akostelanska/NDE-Group-project/README.md

# NDE-Group-project
Repository for MPA-NDE Group Project
