akostelanska/NDE-Group-project/blok_schema.pdf

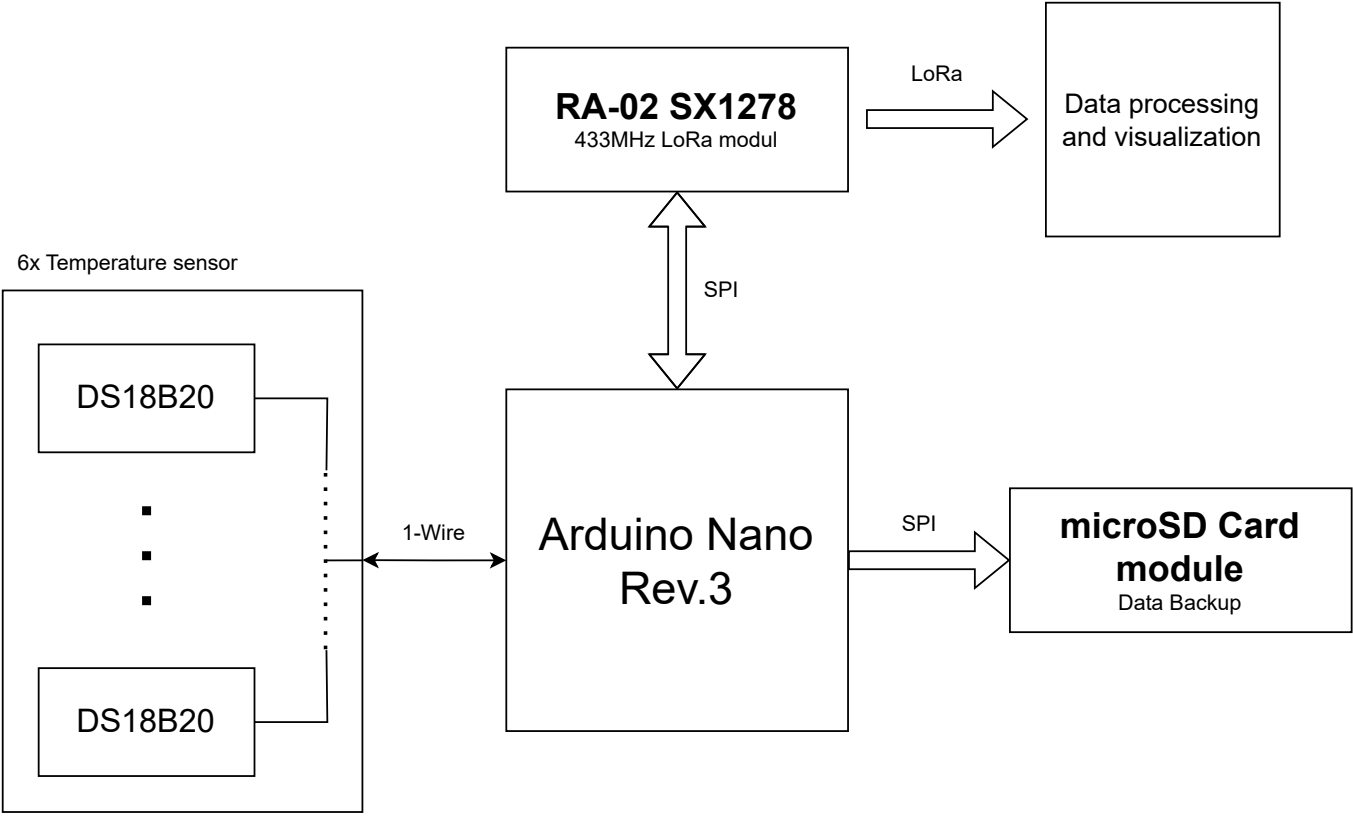
[picture p2: figure]
Arduino Nano Rev.3; 433MHz LoRa modul; Data processing and visualization; LoRa; SPI; 6x Temperature sensor; 1-Wire; microSD Card; module; Data Backup

## Power Supply Battery
