akostelanska/NDE-Group-project/HW/_lib/Ra-02 LoRa--3DModel-STEP-1.STEP

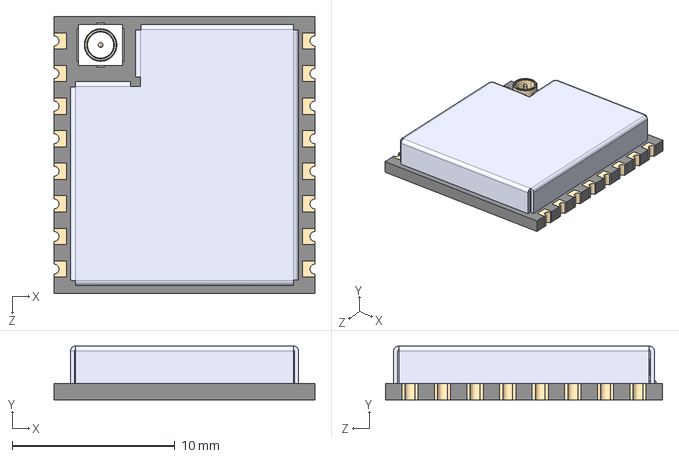
[picture p3: CAD file, 2024-03-19]
HW/_lib/Ra-02 LoRa--3DModel-STEP-1.STEP
16.0 x 3.30 x 17.0 mm
