akostelanska/NDE-Group-project/HW/_lib/LIB_MAX77827CEFD+T/MAX77827CEFD+T.stp

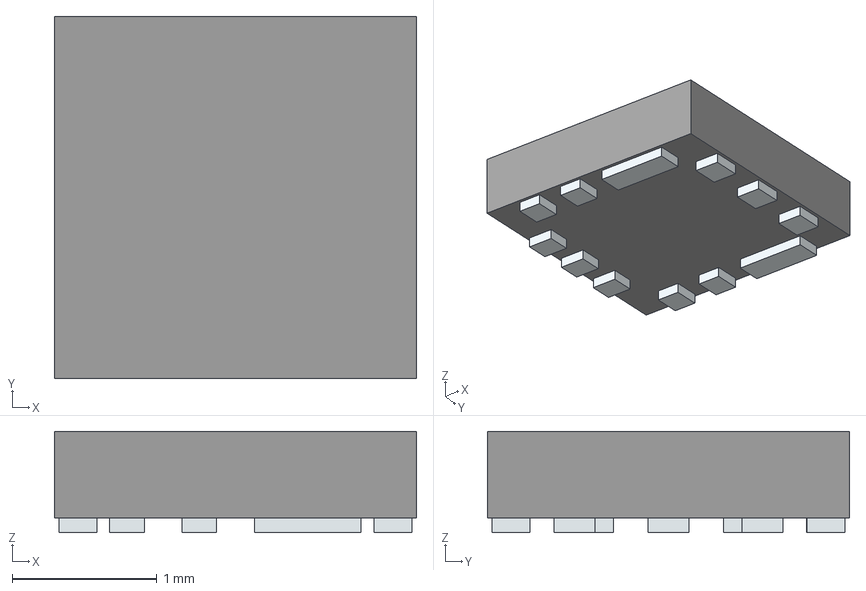
[picture p4: CAD file, 2024-02-26]
HW/_lib/LIB_MAX77827CEFD+T/MAX77827CEFD+T.stp
2.50 x 2.50 x 0.7 mm
Pins
