akostelanska/NDE-Group-project/HW/meracia_jednotka_v1.kicad_pcb

## KiCad design HW/meracia_jednotka_v1.kicad_pcb (2024-03-19)

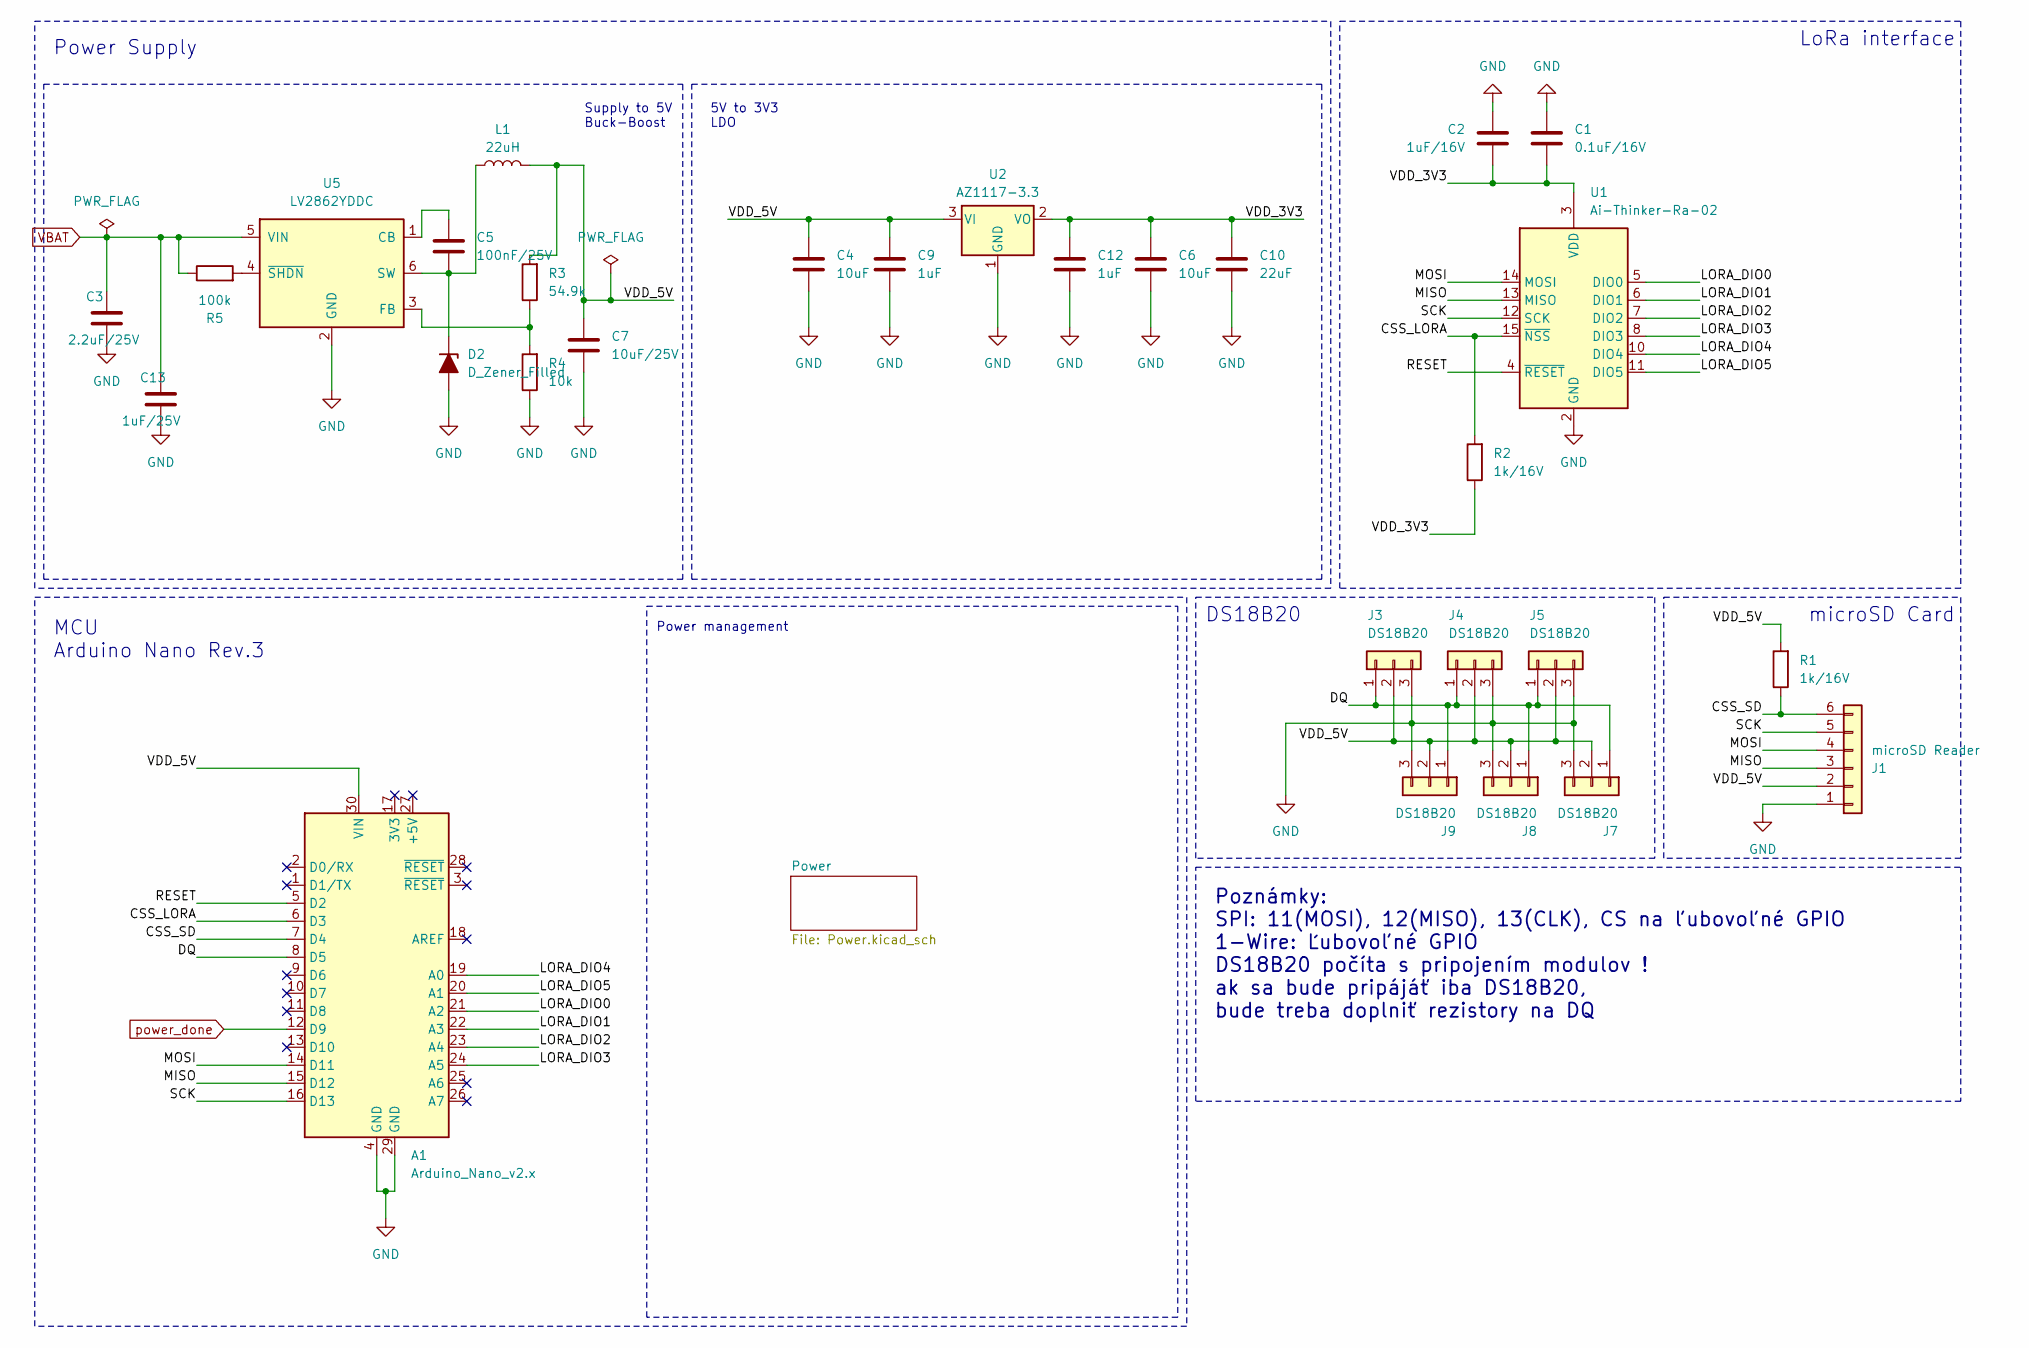
[picture p5: schematic meracia_jednotka_v1.kicad_sch]

Parts:
A1: Arduino_Nano_v2.x; Arduino_Nano
C1: 0.1uF/16V; C_1206_3216Metric_Pad1.33x1.80mm_HandSolder
C2: 1uF/16V; C_1206_3216Metric_Pad1.33x1.80mm_HandSolder
C3: 2.2uF/25V; C_1206_3216Metric_Pad1.33x1.80mm_HandSolder
C4, C6: 10uF; C_1206_3216Metric_Pad1.33x1.80mm_HandSolder
C5: 100nF/25V; C_1206_3216Metric_Pad1.33x1.80mm_HandSolder
C7: 10uF/25V; C_1206_3216Metric_Pad1.33x1.80mm_HandSolder
C9, C12: 1uF; C_0805_2012Metric_Pad1.18x1.45mm_HandSolder
C10: 22uF; C_1206_3216Metric_Pad1.33x1.80mm_HandSolder
C13: 1uF/25V; C_0805_2012Metric_Pad1.18x1.45mm_HandSolder
D2: D_Zener_Filled; D_1206_3216Metric_Pad1.42x1.75mm_HandSolder
J1: microSD Reader; PinHeader_1x06_P2.54mm_Vertical
J3, J4, J5, J7, J8, J9: DS18B20; PinHeader_1x03_P2.54mm_Vertical
L1: 22uH; L_Murata_LQH55DN_5.7x5.0mm
R1, R2: 1k/16V; R_1206_3216Metric_Pad1.30x1.75mm_HandSolder
R3: 54.9k; R_1206_3216Metric_Pad1.30x1.75mm_HandSolder
R4: 10k; R_1206_3216Metric_Pad1.30x1.75mm_HandSolder
R5: 100k; R_1206_3216Metric_Pad1.30x1.75mm_HandSolder
U1: Ai-Thinker-Ra-02; Ai-Thinker-Ra-01-LoRa
U2: AZ1117-3.3; SOT-223-3_TabPin2
U5: LV2862YDDC; SOT-23-6

Connections:
/CSS_LORA: A1.6 (D3), R2.2, U1.15 (~NSS)
/CSS_SD: A1.7 (D4), J1.6, R1.1
/DQ: A1.8 (D5), J3.1, J4.1, J5.1, J7.1, J8.1, J9.1
/LORA_DIO0: A1.21 (A2), U1.5 (DIO0)
/LORA_DIO1: A1.22 (A3), U1.6 (DIO1)
/LORA_DIO2: A1.23 (A4), U1.7 (DIO2)
/LORA_DIO3: A1.24 (A5), U1.8 (DIO3)
/LORA_DIO4: A1.19 (A0), U1.10 (DIO4)
/LORA_DIO5: A1.20 (A1), U1.11 (DIO5)
/MISO: A1.15 (D12), J1.3, U1.13 (MISO)
/MOSI: A1.14 (D11), J1.4, U1.14 (MOSI)
/RESET: A1.5 (D2), U1.4 (~RESET)
/SCK: A1.16 (D13), J1.5, U1.12 (SCK)
/VDD_3V3: C1.2, C2.2, C6.1, C10.1, C12.1, R2.1, U1.3 (VDD), U2.2 (VO)
/VDD_5V: A1.30 (VIN), C4.1, C7.1, C9.1, J1.2, J3.2, J4.2, J5.2, J7.2, J8.2, J9.2, L1.2, R1.2, R3.2, U2.3 (VI)
GND: A1.4 (GND), A1.29 (GND), C1.1, C2.1, C3.2, C4.2, C6.2, C7.2, C9.2, C10.2, C12.2, C13.2, D2.2 (A), J1.1, J3.3, J4.3, J5.3, J7.3, J8.3, J9.3, R4.1, U1.1 (GND), U1.2 (GND), U1.9 (GND), U1.16 (GND), U2.1 (GND), U5.2 (GND); also elsewhere on the board
unnamed: C5.2, D2.1 (K), L1.1, U5.6 (SW)
unnamed: C5.1, U5.1 (CB)
unnamed: R3.1, R4.2, U5.3 (FB)
unnamed: R5.2, U5.4 (~SHDN)
VBAT: C3.1, C13.1, R5.1, U5.5 (VIN); also elsewhere on the board
power_done: A1.12 (D9); also elsewhere on the board

Notes on the sheet:
5V to 3V3 LDO
Poznámky: SPI: 11(MOSI), 12(MISO), 13(CLK), CS na ľubovoľné GPIO 1-Wire: Ľubovoľné GPIO DS18B20 počíta s pripojením modulov ! ak sa bude pripájáť iba DS18B20, bude treba doplniť rezistory na DQ
Supply to 5V Buck-Boost
Power Supply
LoRa interface
MCU Arduino Nano Rev.3
microSD Card
Power management
DS18B20

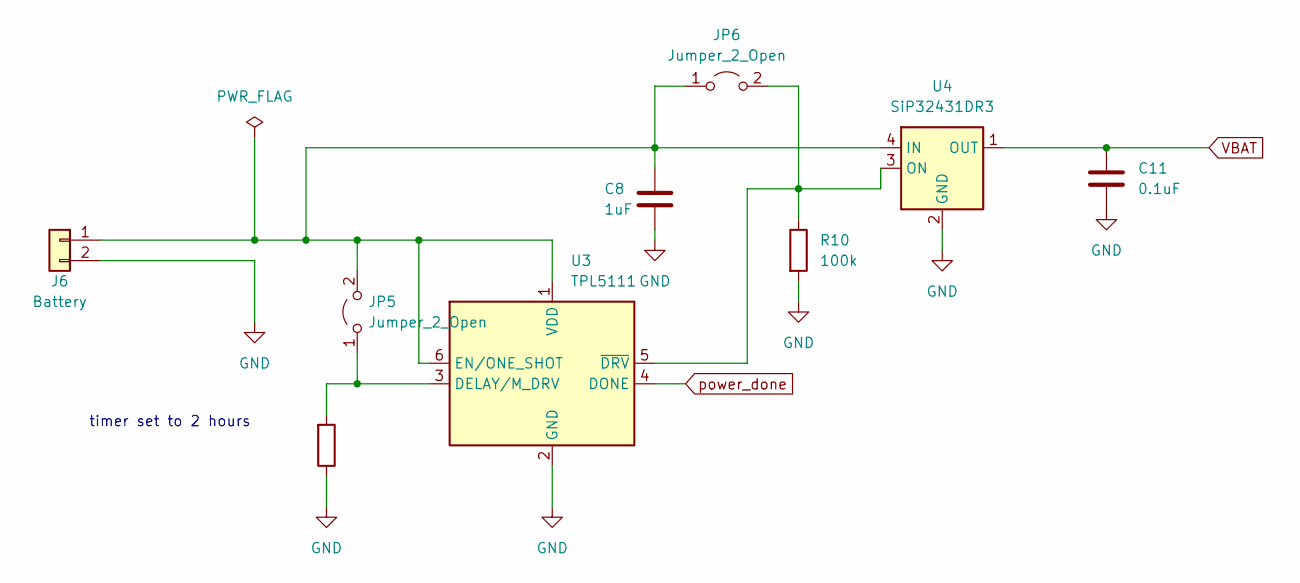
[picture p6: schematic Power.kicad_sch]

Parts:
C8: 1uF; C_1206_3216Metric_Pad1.33x1.80mm_HandSolder
C11: 0.1uF; C_1206_3216Metric_Pad1.33x1.80mm_HandSolder
J6: Battery; BatteryHolder_Keystone_2462_2xAA
JP5, JP6: Jumper_2_Open; PinHeader_1x02_P2.54mm_Vertical
R9: 57k; R_1206_3216Metric_Pad1.30x1.75mm_HandSolder
R10: 100k; R_1206_3216Metric_Pad1.30x1.75mm_HandSolder
U3: TPL5111; SOT-23-6
U4: SiP32431DR3; SOT-363_SC-70-6

Connections:
GND: C8.1, C11.2, J6.2, R9.1, R10.2, U3.2 (GND), U4.2 (GND), U4.5 (GND); also elsewhere on the board
unnamed: C8.2, J6.1, JP5.2 (B), JP6.1 (A), U3.1 (VDD), U3.6 (EN/ONE_SHOT), U4.4 (IN)
unnamed: JP5.1 (A), R9.2, U3.3 (DELAY/M_DRV)
unnamed: JP6.2 (B), R10.1, U3.5 (~DRV), U4.3 (ON)
VBAT: C11.1, U4.1 (OUT); also elsewhere on the board
power_done: U3.4 (DONE); also elsewhere on the board

Notes on the sheet:
timer set to 2 hours

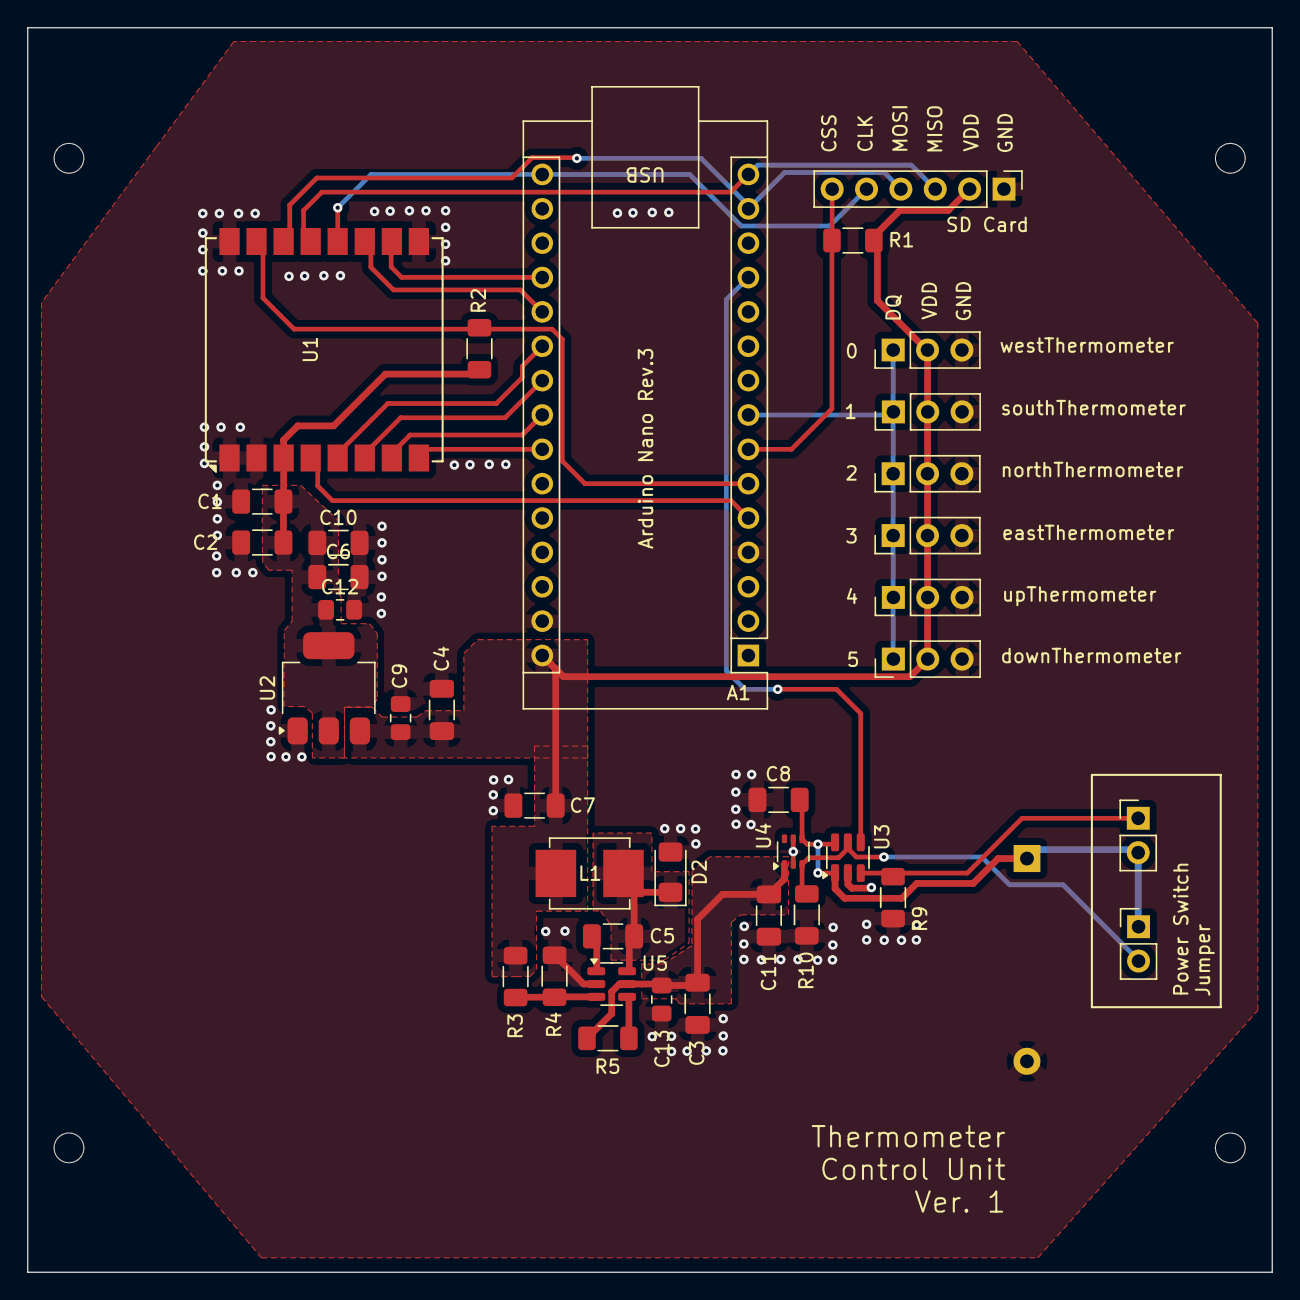
[picture p7: board meracia_jednotka_v1.kicad_pcb from above]

Board: 2 copper layers, 92.0 x 92.0 mm, 38 parts (1 on the bottom side), 25 nets.
