akostelanska/NDE-Group-project/(commit log)

2024-02-26 Add files via upload
    initial commit
    [MAX77827CEFD+T.stp, meracia_jednotka_v1.kicad_pcb, meracia_jednotka_v1.kicad_sch]
2024-03-05 Add files via upload
    LDO added
    [meracia_jednotka_v1.kicad_sch]
2024-03-13 Add files via upload
    napajanie vzor
    [napajanie.kicad_pcb, napajanie.kicad_sch]
2024-03-19 Add files via upload
    layout update
    [Power.kicad_sch, Ra-02 LoRa--3DModel-STEP-1.STEP, meracia_jednotka_v1.kicad_pcb, meracia_jednotka_v1.kicad_sch]
